jcab41-sys/JC_Desktop_Pad_Releases/Mode_d_emploi_JCharles_Touch.pdf

# JCharles Touch

## Mode d'emploi du pad et du logiciel JCharles desktop

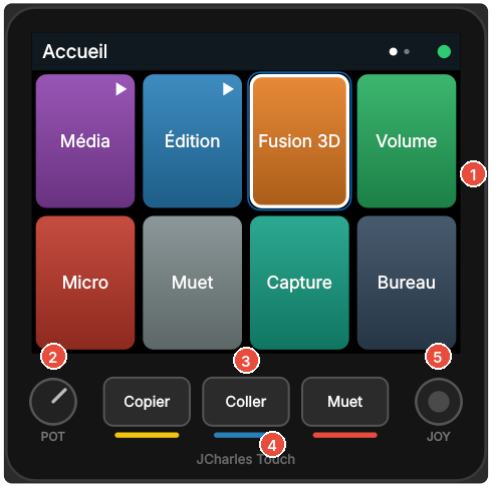
[picture p1: figure]

### 1. Le pad en bref 2. Installer et connecter 3. L'Éditeur : vos boutons 4. Les types d'action 5. Dossiers et glisser-déposer

### 6. Macros 7. Touches physiques et combinaisons 8. Pages Appareil, Matériel, Apparence 9. Les écrans du pad 10. Mises à jour et dépannage

Logiciel 0.31 · pad V2 firmware 2.14. Les captures du logiciel viennent de la version 0.31 ; les écrans du pad sont redessinés d'après le programme du pad.

## 1. Le pad en bref

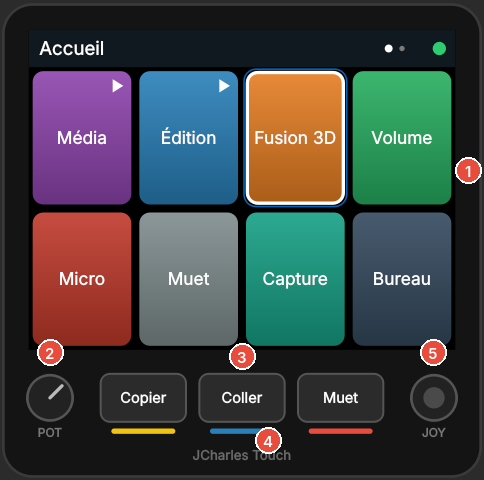
[picture p2: figure]

Le pad se branche au PC par un câble USB. Il peut aussi fonctionner en Bluetooth, sur batterie. La V2 a aussi un petit haut-parleur (jeux, minuteur) et peut recevoir un micro en option.

Le pad se suffit à lui-même pour les raccourcis clavier, le texte et les touches multimédia. Le logiciel JCharles desktop sert à le configurer, et il doit rester ouvert pour les actions « PC » : lancer un programme, ouvrir un site, la météo, la santé du PC, les tuiles à état.

L'écran tactile (4 pouces sur la V2) : vos boutons, appelés « tuiles », rangés en pages et en dossiers.

1

2 Le potentiomètre (bouton rotatif) : par défaut, il règle le volume du PC.
3 Les 3 touches sensitives (TTP223) : il suffit de les effleurer. Par défaut : Copier, Coller, Muet. 4 Les LED des touches : leur couleur et leur comportement se règlent dans le logiciel.
Le joystick : par défaut, il bouge la souris et son clic fait un clic gauche. Il peut aussi tourner une vue 3D (Fusion 360) ou faire défiler.

5

JCharles Touch — mode d'emploi · page 2 / 27

## 2. Installer et connecter

### Installer le logiciel

Téléchargez JCharles_desktop_Setup.exe depuis la page des versions sur GitHub (dépôt JC_Desktop_Pad_Releases).
Lancez-le. Si Windows affiche « Windows a protégé votre ordinateur », cliquez sur Informations complémentaires, puis sur Exécuter quand même.
Le logiciel s'ouvre et cherche le pad tout seul.

### Connecter le pad

Branchez le câble USB. Le logiciel reconnaît le pad à sa réponse, pas au numéro du port COM. En bas à gauche apparaissent un point vert et « Connecté · JCharles Touch V2 ». Sinon, cliquez sur Se connecter ou sur ☰ Chercher.

1.

2.

3.

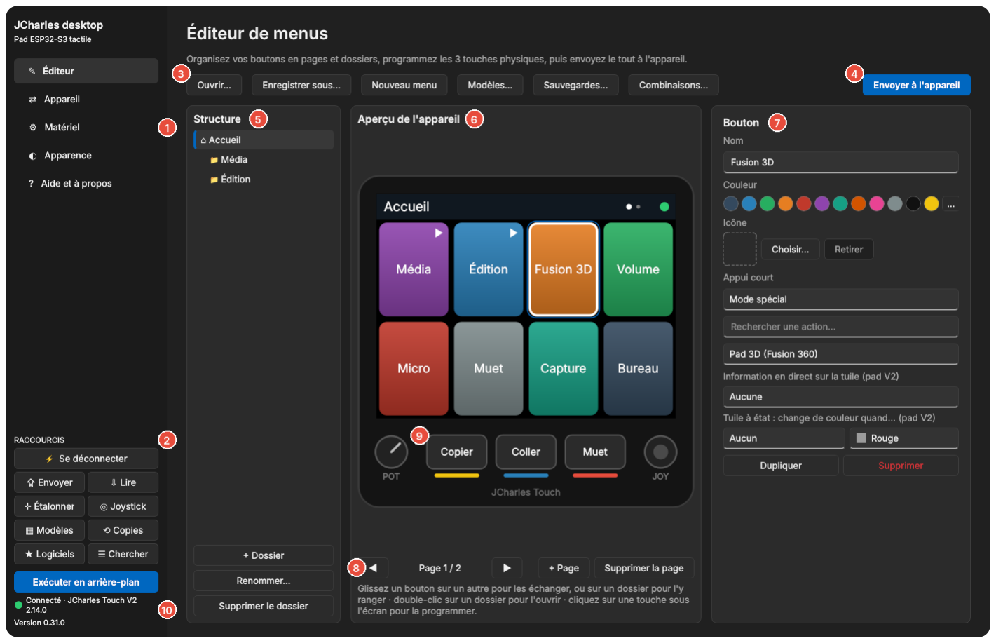
[picture p3: figure]

1 Les pages du logiciel : Éditeur, Appareil, Matériel, Apparence, Aide et à propos. Raccourcis : se connecter, Envoyer (le menu vers le pad), Lire (le menu du pad), Étalonner l'écran, test du Joystick, Modèles, Copies (sauvegardes), Logiciels (un dossier avec vos logiciels les plus utilisés), Chercher le pad.

2

Barre d'outils : ouvrir ou enregistrer un menu sur le PC, repartir d'un nouveau menu, choisir un modèle, retrouver une sauvegarde, régler les combinaisons.

3

Envoyer à l'appareil : copie le menu, les icônes et les réglages dans le pad. Rien ne change sur le pad tant que vous n'avez pas envoyé.

4

5 Structure : l'accueil et ses dossiers, sous forme d'arbre.
6 Aperçu : le pad tel qu'il s'affichera. Cliquez sur une tuile pour la modifier. 7 Panneau de réglage de la tuile ou de la touche sélectionnée.
8 Pages : page précédente / suivante, ajouter une page, supprimer la page.
9 Les touches physiques : cliquez dessus pour les programmer.
État de la connexion et version du logiciel. Exécuter en arrière-plan ferme la fenêtre ; le logiciel continue dans la zone de notification, près de l'horloge.

10

## 3. L'Éditeur : vos boutons

### Créer un bouton

Dans l'aperçu, cliquez sur une case vide marquée +, puis sur Ajouter un bouton. Si la page est pleine, cliquez sur + Page sous l'aperçu.

### Régler un bouton

Cliquez sur la tuile dans l'aperçu : ses réglages s'affichent à droite.

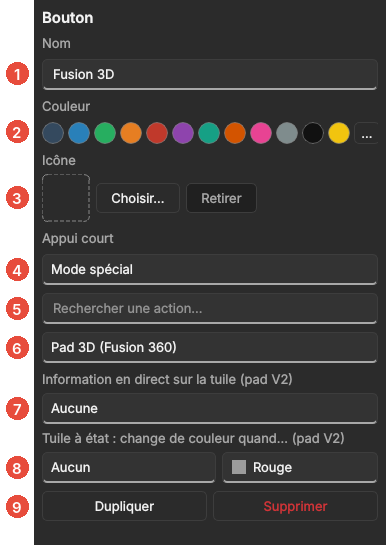
[picture p4: figure]

Pour certains types d'action, une rubrique Appui long (optionnel) apparaît en bas : une seconde action, déclenchée en gardant le doigt 0,6 seconde sur la tuile.

Nom : le texte de la tuile. C'est ici qu'on renomme un bouton.

1

Couleur : une pastille, ou … pour une couleur au choix.

2

Icône : Choisir… une image du PC, ou Retirer. Pour un site ou un logiciel, l'icône est proposée toute seule.

3

Appui court : le type d'action (voir le chapitre 4).

4

Rechercher une action : cliquez dans le champ pour voir toute la liste, ou tapez un mot (« capture », « volume », « dictée »…).

5

Le détail de l'action : il change selon le type choisi.

6

Information en direct (pad V2) : la tuile affiche une valeur à la place de son icône (processeur, mémoire, musique en cours, heure, température).

7

Tuile à état (pad V2) : la tuile change de couleur quand un état est actif (voir plus bas).

8

Dupliquer crée une copie de la tuile ; Supprimer l'efface.

9

### Le menu du clic droit

Clic droit sur une tuile de l'aperçu : Déplacer vers… (un autre dossier ou l'accueil), Déplacer vers la page…, Dupliquer, Supprimer. Sur un dossier, le menu propose aussi Ouvrir le dossier.

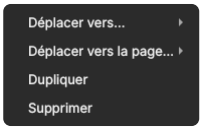
[picture p5: figure]

### Tuiles à état

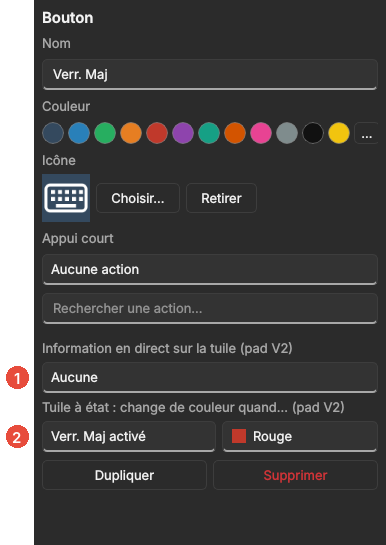
[picture p6: figure]

Exemple : une tuile « Micro » qui coupe le micro et devient rouge quand il est coupé. Les états du PC demandent que le logiciel soit ouvert.

Aucune information en direct ici : la tuile garde son nom et son icône.

1

L'état surveillé et la couleur à prendre. États possibles : micro du PC coupé, son du PC coupé, Verr. Maj activé, Verr. Num activé, micro du pad coupé.

2

## 4. Les types d'action

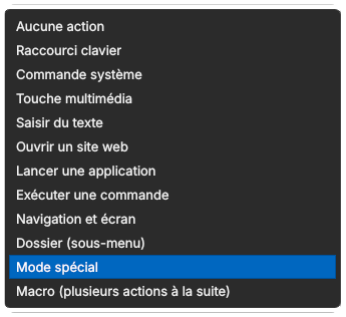
[picture p7: figure]

Choisissez le type dans la liste Appui court. Les champs en dessous s'adaptent.

Le plus rapide : cliquez dans Rechercher une action et choisissez dans la liste. Le type, les touches, le nom et l'icône se remplissent tout seuls.

Type | Ce qu'il fait | Logiciel ouvert ?
Raccourci clavier | Une combinaison de touches. Cochez Ctrl, Maj, Alt ou Win, puis tapez la touche (lettre, chiffre, F1…, enter, esc, tab…). La liste « Choisir un raccourci courant » propose les plus utilisés. | Non
Commande système | Une action Windows toute prête : capture d'écran, dictée vocale, Accès vocal, verrouiller, bureau suivant, presse-papiers, émojis, paramètres… | Selon la commande
Touche multimédia | Lecture / pause, piste suivante ou précédente, volume, muet, luminosité. | Non
Saisir du texte | Tape un texte, accents compris (é, è, à, ç, ù, ê, €…). Réglez le clavier (AZERTY ou QWERTY) dans Matériel. | Non
Ouvrir un site web | Ouvre une adresse dans le navigateur. L'icône du site est récupérée toute seule. | Oui
Lancer une application | Lance un logiciel (bouton Parcourir ou liste des logiciels installés). | Oui
Exécuter une commande | Une ligne de commande Windows. | Oui
Navigation et écran | Page suivante ou précédente, retour à l'accueil, calibrer l'écran tactile, naviguer dans les tuiles avec le joystick. | Non

Dossier (sous-menu) | La tuile ouvre un dossier rempli d'autres tuiles (chapitre 5). | Non
Mode spécial | Ouvre un écran du pad : Pad 3D (Fusion 360), Volume, Météo, Jeux, Pomodoro et minuteurs, Micro, Santé du PC, Présentation (chapitre 9). | Selon l'écran
Macro | Plusieurs actions à la suite, avec des pauses (chapitre 6). | Selon les étapes

Exemple de page avec des modes spéciaux, une macro, une tuile à état et une tuile en direct :

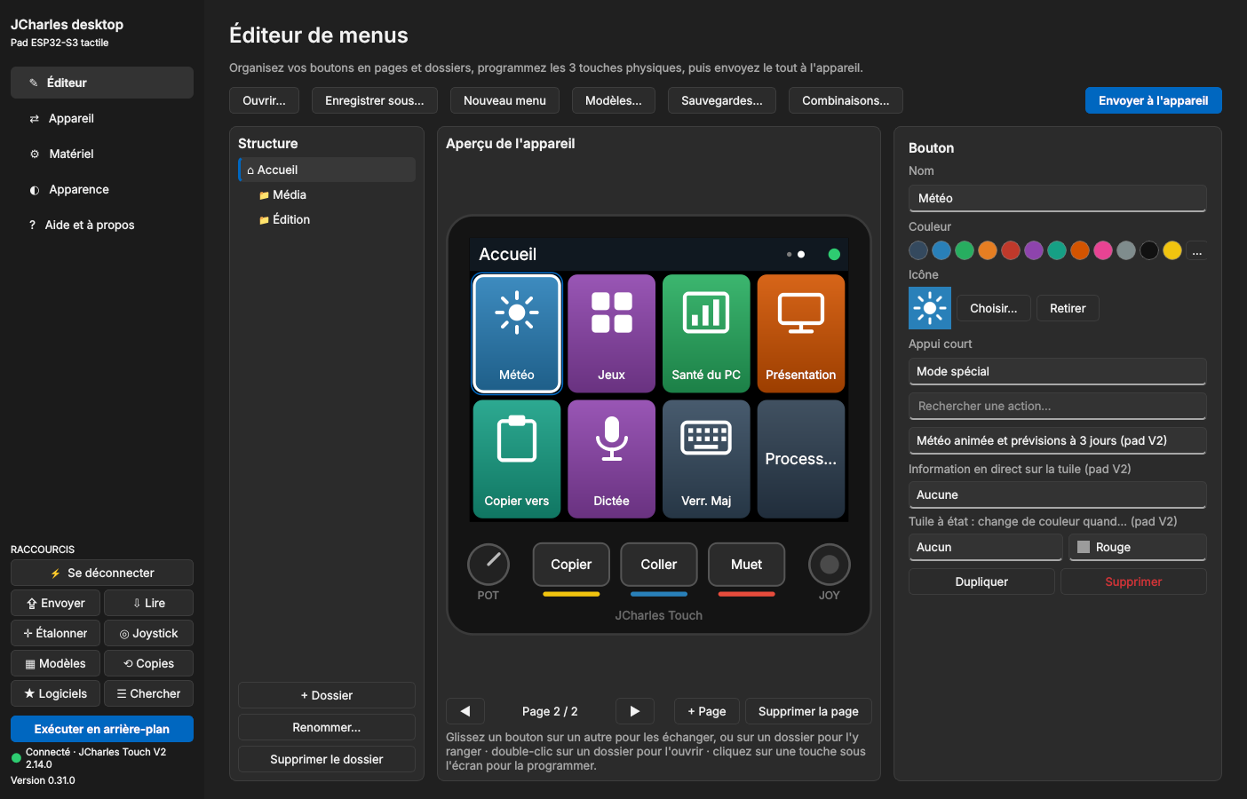
[picture p8: figure]

## 5. Dossiers et glisser-déposer

### Créer un dossier

Cliquez sur + Dossier sous la Structure. Vous pouvez aussi choisir le type Dossier (sous-menu) pour une tuile. Sur le pad, un dossier se reconnaît à son petit triangle blanc en haut à droite.

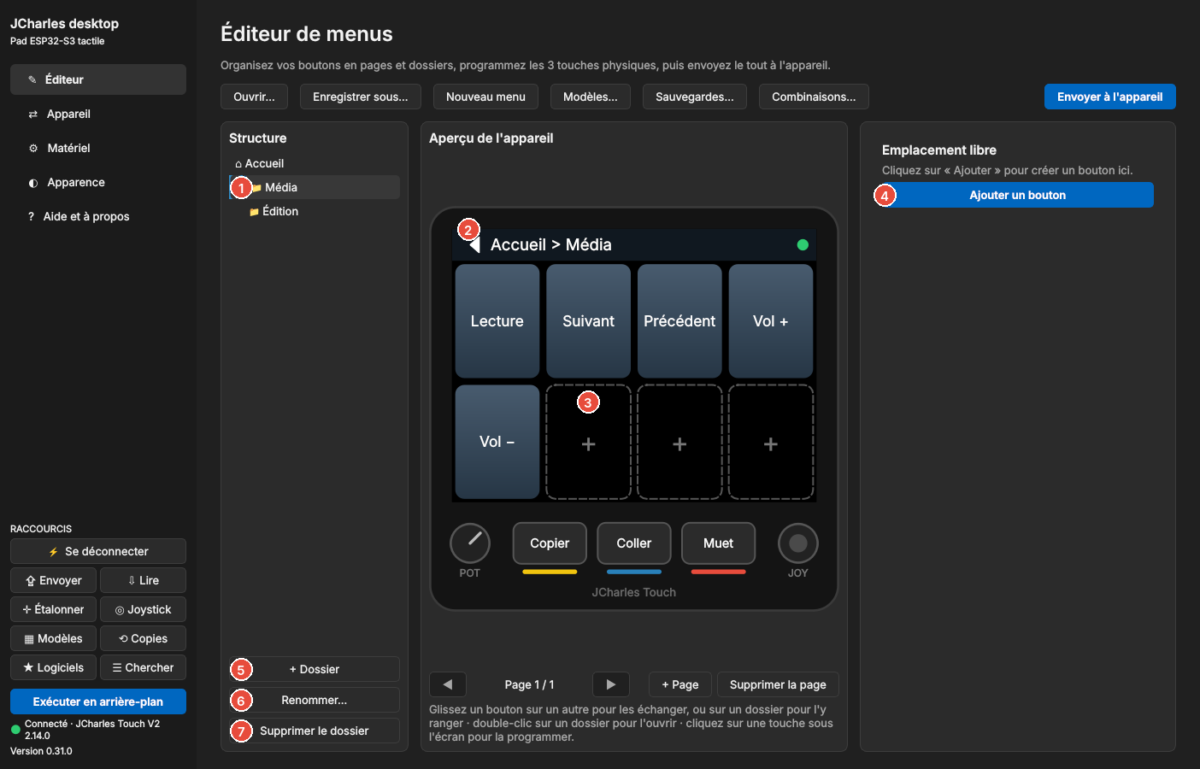
[picture p9: figure]

### Glisser-déposer

Vous faites… | Résultat
Glisser une tuile sur une autre tuile | Les deux tuiles échangent leur place.
Glisser une tuile sur un dossier (dans l'aperçu) | La tuile entre dans le dossier, avec tous ses réglages.

1 Le dossier ouvert dans la Structure : l'aperçu montre son contenu.
2 Le chemin (Accueil > Média) et la flèche de retour, comme sur le pad. 3 Cases libres : cliquez sur un + pour y créer une tuile.
4 Ajouter un bouton dans la case choisie.
5 + Dossier : un nouveau dossier dans le niveau affiché.
6 Renommer… le dossier sélectionné.
7 Supprimer le dossier (avec son contenu).

Glisser une tuile hors de l'aperçu, sur un dossier de la Structure | La tuile est rangée dans ce dossier.
Glisser un dossier dans la Structure | Le dossier change de place : dans un autre dossier, ou de retour à l'accueil.
Glisser une tuile sur la flèche ◀ ou ▶ sous l'aperçu | La tuile passe à la page précédente ou suivante.
Double-clic sur un dossier | Ouvre le dossier.

Pour déplacer une tuile vers une autre page, le plus simple est le clic droit, puis Déplacer vers la page….

## 6. Macros

Une macro enchaîne plusieurs actions avec un seul bouton : par exemple « copier, passer à l'autre fenêtre, coller ».

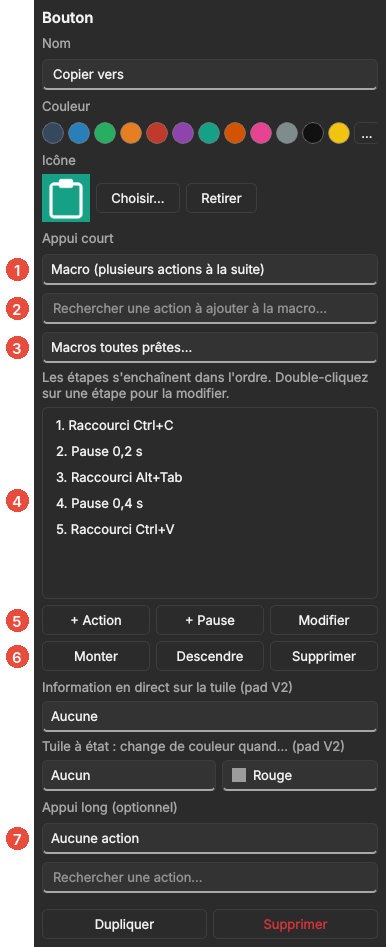
[picture p10: figure]

Si une étape arrive trop tôt (la fenêtre n'est pas encore ouverte), allongez la pause qui la précède.

40 étapes au plus, 10 secondes au plus par pause. Pendant une pause, l'écran du pad ne réagit pas.

1 Type d'action Macro.
Rechercher une action : l'action choisie est ajoutée comme étape.

2

Macros toutes prêtes : copier vers l'autre fenêtre, tout copier, rechercher la sélection, enregistrer et fermer, pause (son coupé et PC verrouillé), bureau propre, Teams (micro et caméra), capture vers Paint, formule de politesse.

3

Les étapes, dans l'ordre. Double-cliquez sur une étape pour la modifier.

4

+ Action ajoute une étape (raccourci, texte, multimédia, site, logiciel,
commande) ; + Pause ajoute une attente ; Modifier l'étape sélectionnée.

5

Monter / Descendre changent l'ordre ; Supprimer enlève l'étape.

6

7 Une macro peut aussi avoir un appui long.

## 7. Touches physiques et combinaisons

Cliquez sur une touche sous l'aperçu (Copier, Coller, Muet…) pour la programmer.

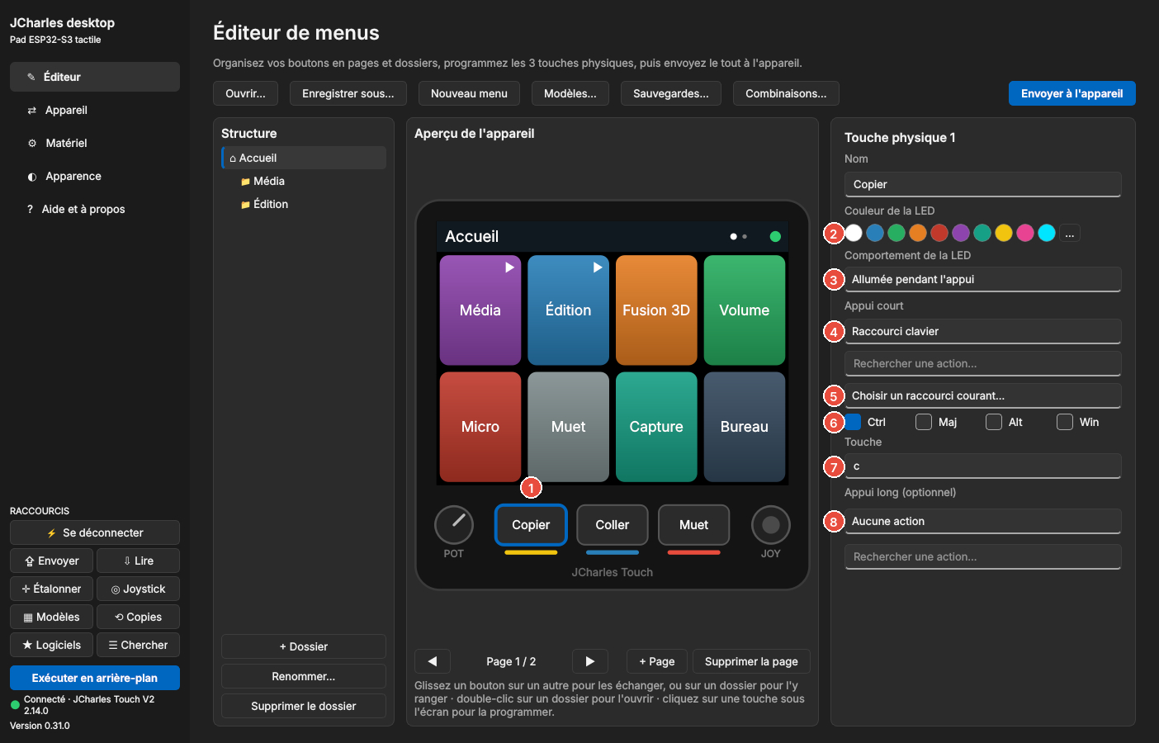
[picture p11: figure]

1 La touche sélectionnée.
2 Couleur de la LED de la touche.
Comportement de la LED : éteinte, allumée pendant l'appui, bascule à chaque appui, ou veilleuse avec pleine lumière à l'appui.

3

Appui court : les mêmes types d'action que les tuiles (sauf dossier et mode spécial), macros comprises.

4

5 « Choisir un raccourci courant » : la liste des raccourcis les plus utilisés.
6 Les touches de modification : Ctrl, Maj, Alt, Win.
7 La touche du raccourci.
8 Appui long : une seconde action en gardant le doigt sur la touche.

### Combinaisons

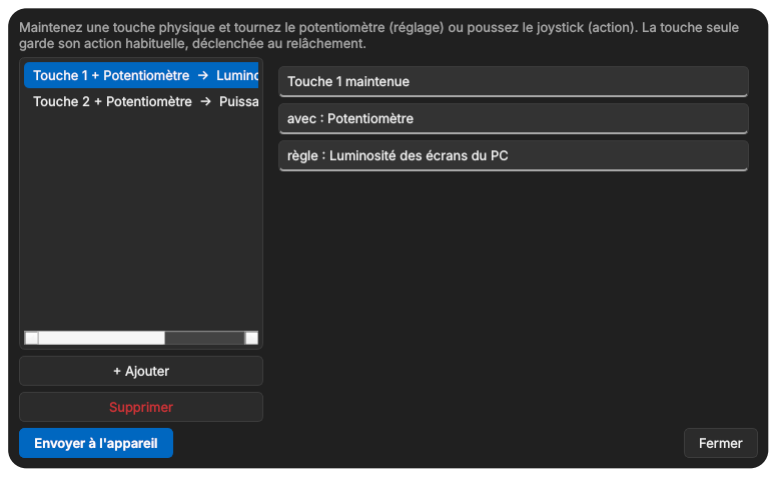
[picture p12: figure]

Bouton Combinaisons… de la barre d'outils. Maintenez une touche physique et :

- tournez le potentiomètre pour régler autre chose : luminosité des écrans du PC, puissance du micro du PC, luminosité de l'écran du pad ou des LED, volume ;
- poussez le joystick pour déclencher une action.

La touche seule garde son action habituelle, déclenchée au relâchement.

### Modèles et sauvegardes

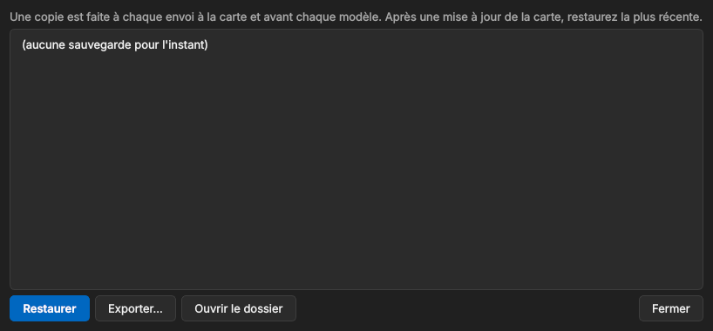
[picture p13: figure]
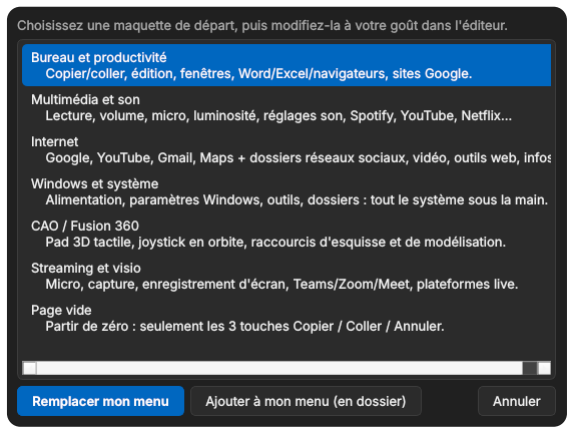
[picture p14: figure]

Modèles… : un menu tout prêt pour démarrer (bureau et productivité, multimédia et son, Internet, Windows et système, CAO / Fusion 360, streaming et visio, page vide), à modifier ensuite. Sauvegardes… : une copie du menu est faite à chaque envoi au pad et avant chaque modèle. En cas d'erreur, restaurez la plus récente.

## 8. Pages Appareil, Matériel, Apparence

### Appareil

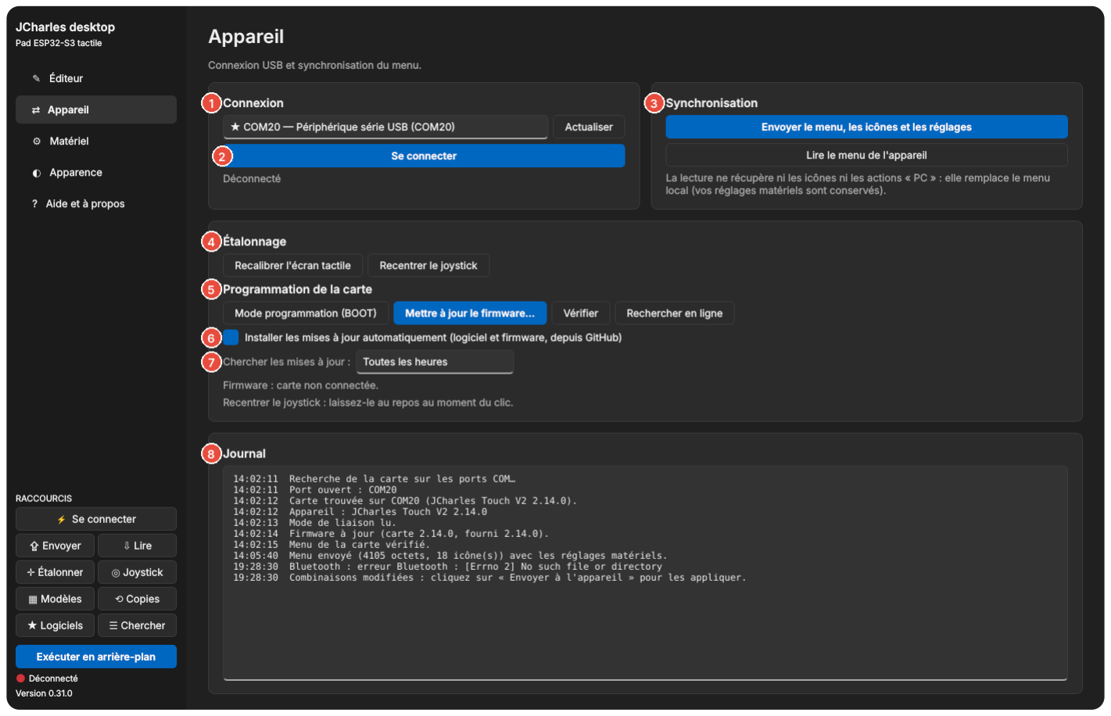
[picture p15: figure]

### Matériel

Tous les réglages du pad. Ils partent au pad avec Envoyer à l'appareil, sauf mention contraire.

1 Connexion : le port COM du pad, et Actualiser.
2 Se connecter / Se déconnecter.
Synchronisation : envoyer le menu, les icônes et les réglages ; ou lire le menu du pad (sans les icônes ni les actions PC).

3

Étalonnage : recalibrer l'écran tactile, recentrer le joystick (laissez-le au repos au moment du clic).

4

Programmation de la carte : mode programmation, Mettre à jour le firmware…, Vérifier, Rechercher en ligne.

5

6 Mises à jour automatiques du logiciel et du firmware, depuis GitHub.
7 Rythme de recherche des mises à jour.
8 Journal : ce que fait le logiciel. À copier pour signaler un problème.

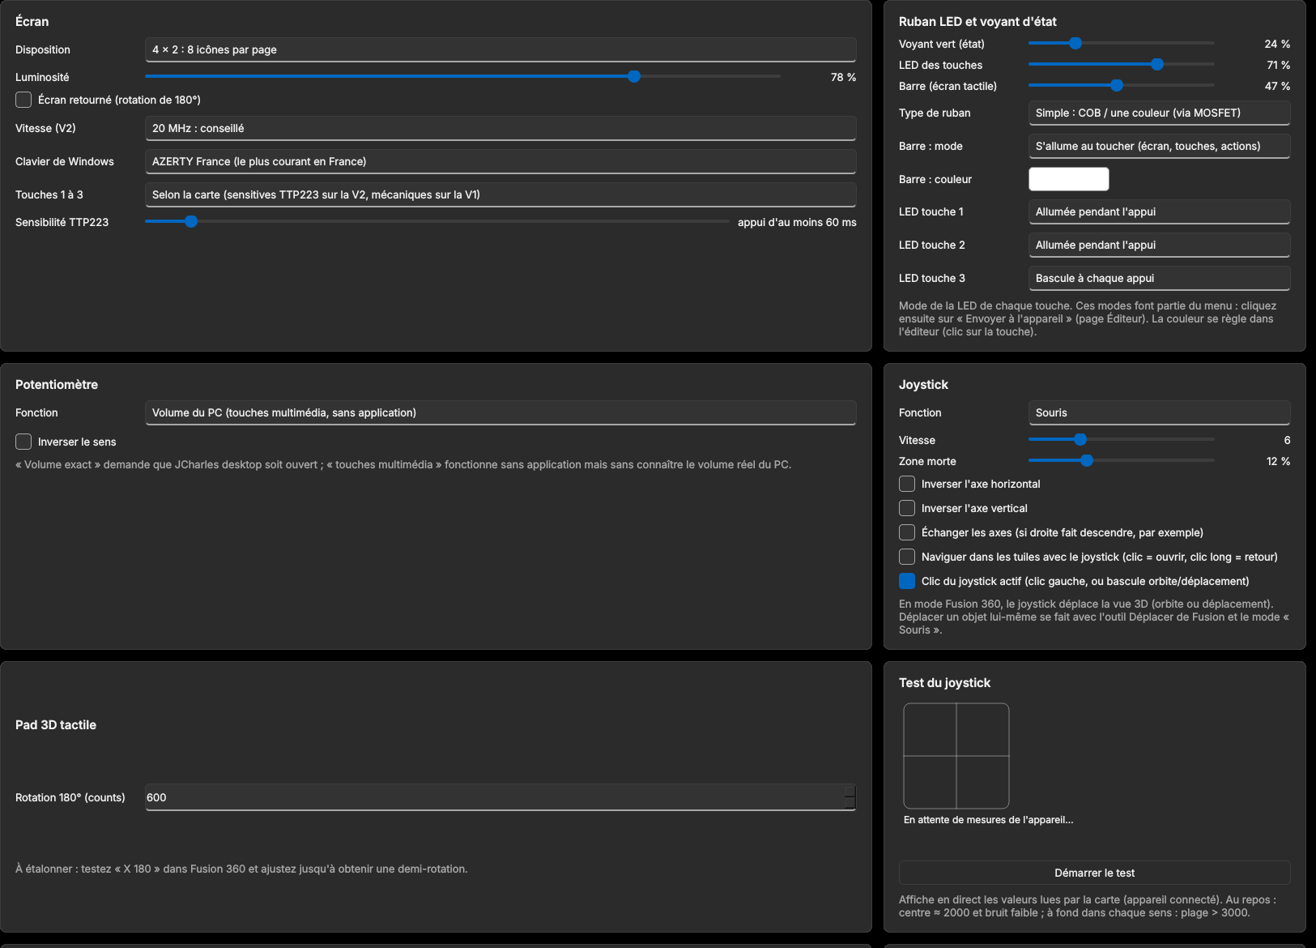
[picture p16: figure]

Rubrique | Ce qu'on y règle
Écran | Disposition (4 × 2 ou 3 × 2 tuiles), luminosité, écran retourné, Clavier de Windows (AZERTY France ou QWERTY US), type et sensibilité des touches.
Ruban LED et voyant | Luminosité du voyant, des LED des touches et du ruban ; type de ruban ; mode et couleur de la barre ; comportement de chaque LED.
Potentiomètre | Sa fonction (volume du PC, volume exact, luminosité de l'écran du pad, intensité des LED, désactivé), sens inversé.
Joystick | Fonction (souris, orbite 3D, déplacement 3D, défilement), vitesse, zone morte, axes, navigation dans les tuiles, clic.
Test du joystick / Pad 3D | Valeurs lues en direct ; réglage de la rotation de 180° pour Fusion 360.
Liaison avec le PC | USB, Bluetooth ou automatique ; oublier les appairages Bluetooth ; tester le Bluetooth.
Écran tactile | Sensibilité et calibration.

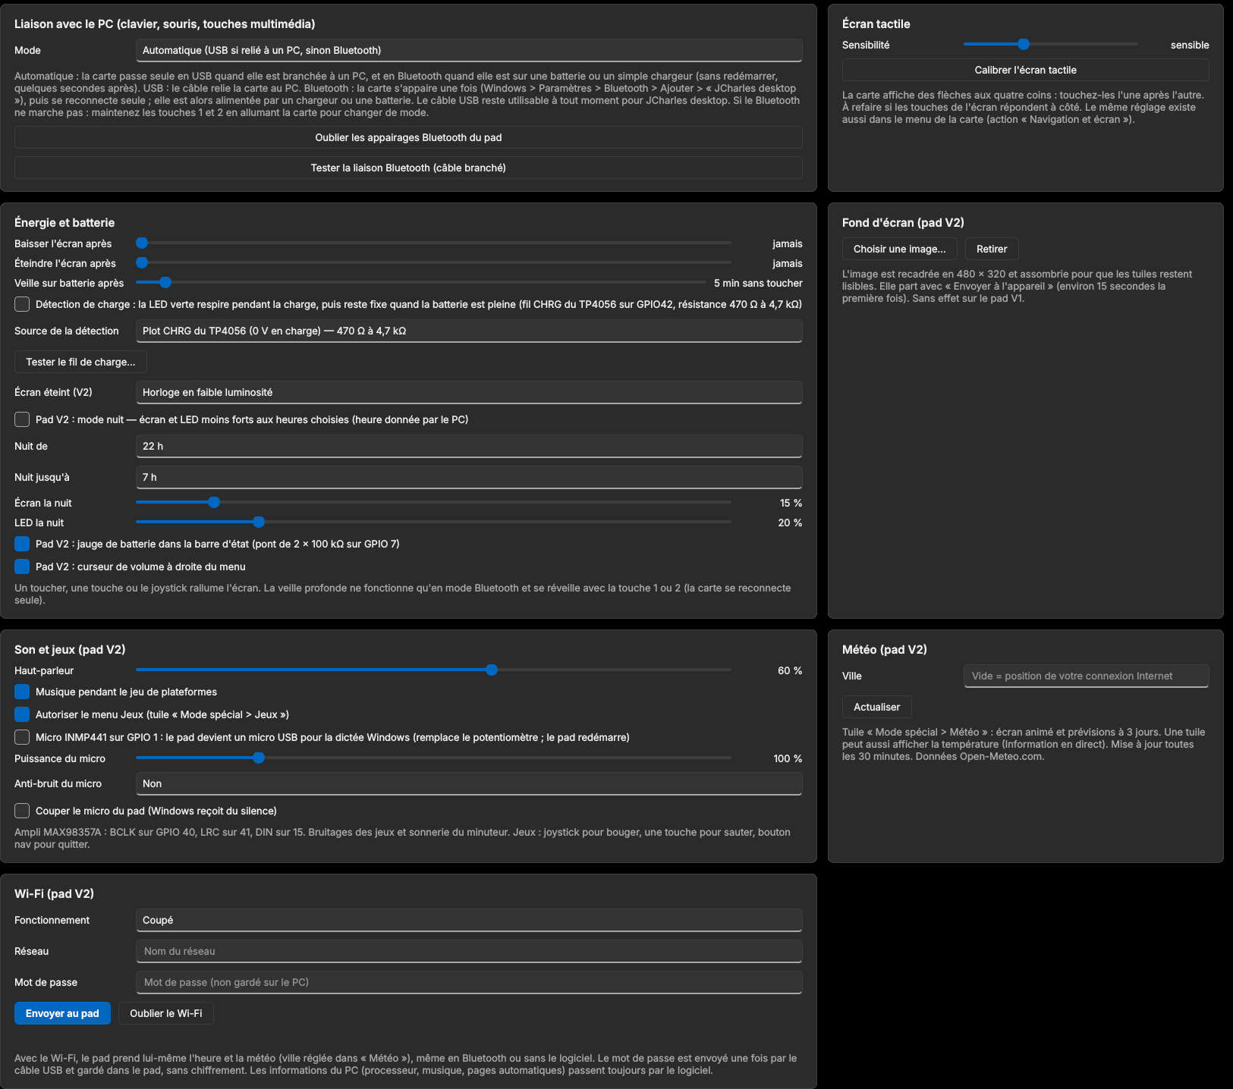
[picture p17: figure]

Rubrique | Ce qu'on y règle
Énergie et batterie | Baisser puis éteindre l'écran, veille sur batterie, détection de charge, horloge de veille, mode nuit (heures, luminosité de l'écran et des LED la nuit), jauge de batterie, curseur de volume à droite du menu.
Fond d'écran (V2) | Une image derrière les tuiles.
Son et jeux (V2) | Volume du haut-parleur, musique, menu Jeux, micro du pad (activation, puissance, anti-bruit, couper).
Météo (V2) | La ville (vide = position de la connexion Internet).
Wi-Fi (V2) | Pour que le pad prenne lui-même l'heure et la météo.

### Apparence

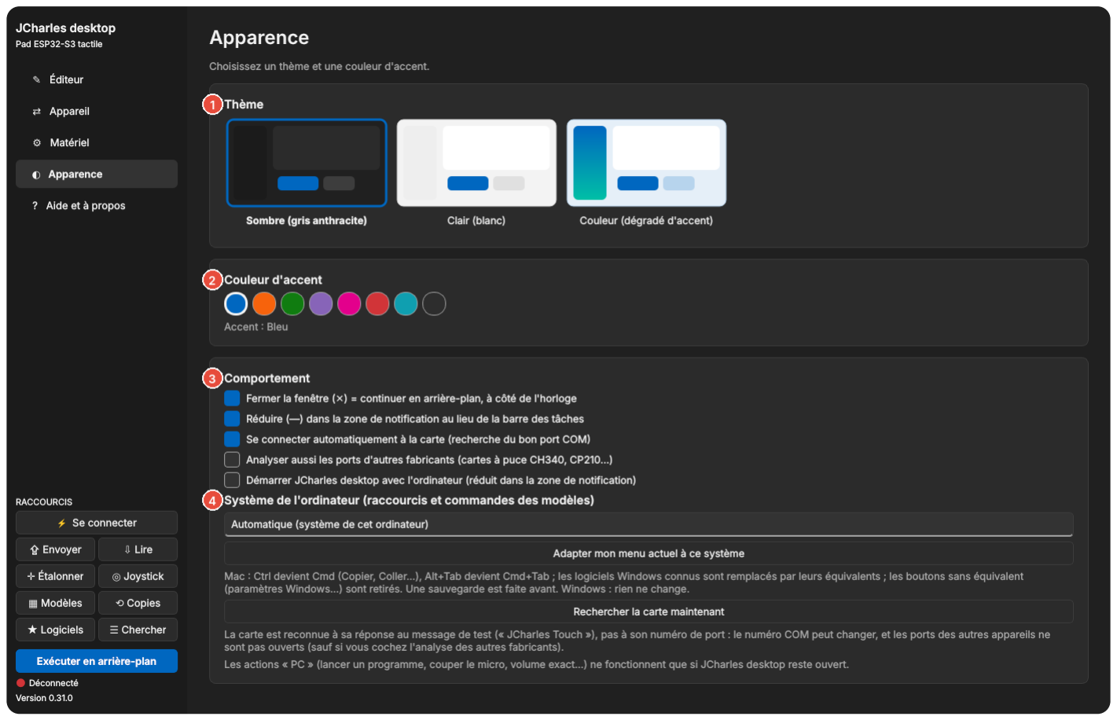
[picture p18: figure]

1 Thème du logiciel : sombre, clair ou couleur.
2 Couleur d'accent.
Comportement : fermer ou réduire dans la zone de notification, connexion automatique, démarrage avec Windows.

3

4 Système de l'ordinateur : adapte les raccourcis pour un Mac si besoin.

## 9. Les écrans du pad

### Le menu

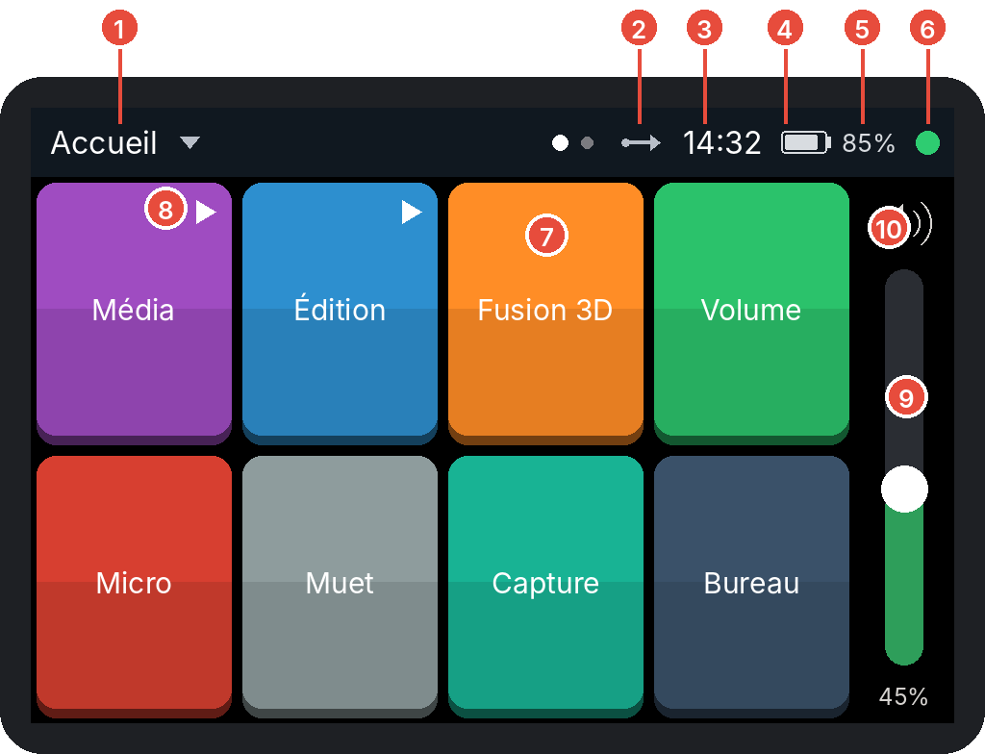
[picture p19: figure]

Glissez le doigt vers la gauche ou la droite pour changer de page. Dans un dossier, la flèche ◀ en haut à gauche ramène au niveau précédent.

1 Le titre (nom de la page ou du dossier). Touchez l'en-tête pour ouvrir l'écran Raccourcis. 2 Les points de page : le point blanc est la page affichée.
3 La liaison : symbole USB ou Bluetooth.
4 L'heure, donnée par le PC (ou le Wi-Fi).
5 La batterie.
6 Le voyant PC : vert = logiciel JCharles desktop connecté.
7 Une tuile : touchez-la pour lancer son action ; gardez le doigt 0,6 s pour l'appui long. 8 Un dossier : petit triangle blanc.
9 Le curseur de volume : glissez de haut en bas.
10 Le haut-parleur : touchez-le pour couper ou rétablir le son du PC.

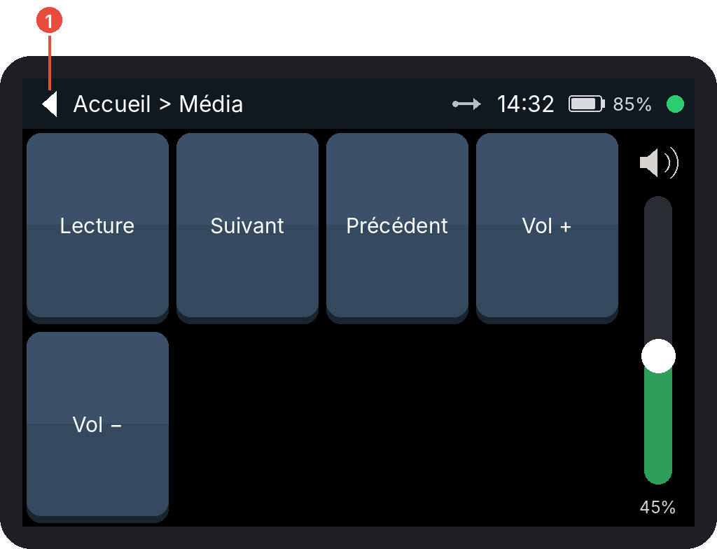
[picture p20: figure]

Un dossier ouvert : (1) retour.

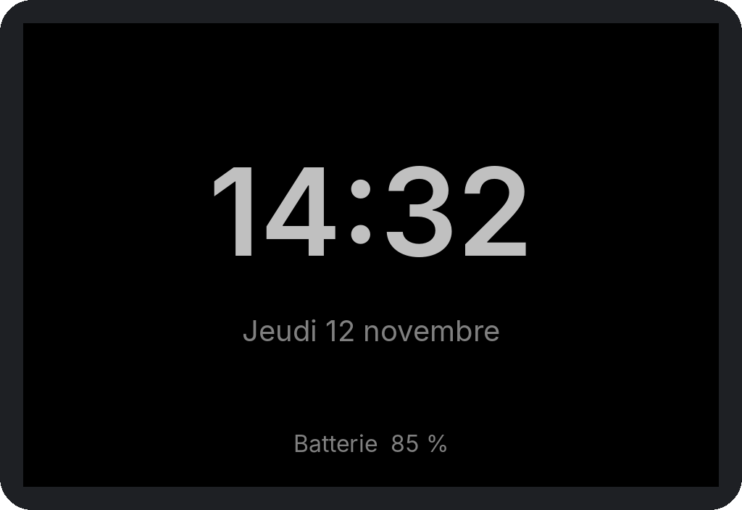
[picture p21: figure]

Écran de veille : l'horloge en faible lumière. Touchez pour rallumer.

### Raccourcis (toucher l'en-tête)

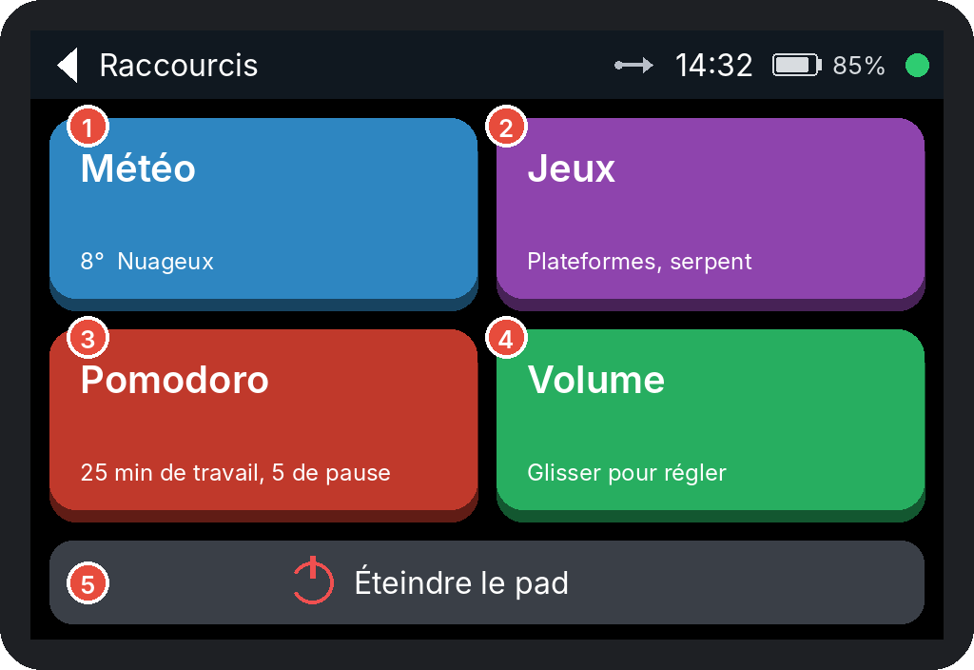
[picture p22: figure]

1 Météo.
2 Jeux.
Pomodoro : 25 min de travail, 5 min de pause ; touchez de nouveau pour l'arrêter.

3

4 Volume.
5 Éteindre le pad.

### Volume et Pad 3D

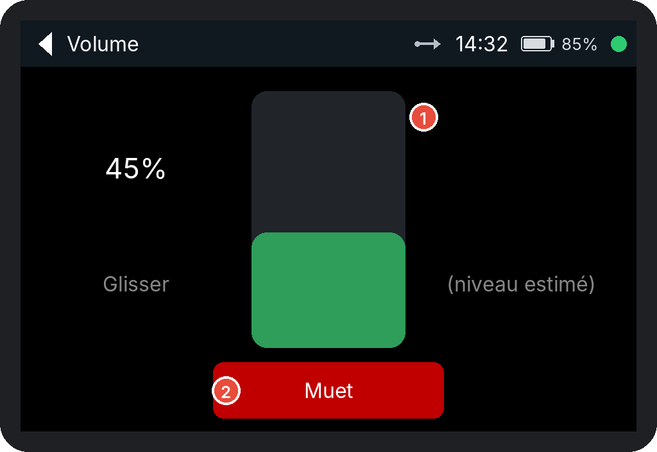
[picture p23: figure]

1 Glissez pour régler le volume. 2 Muet.

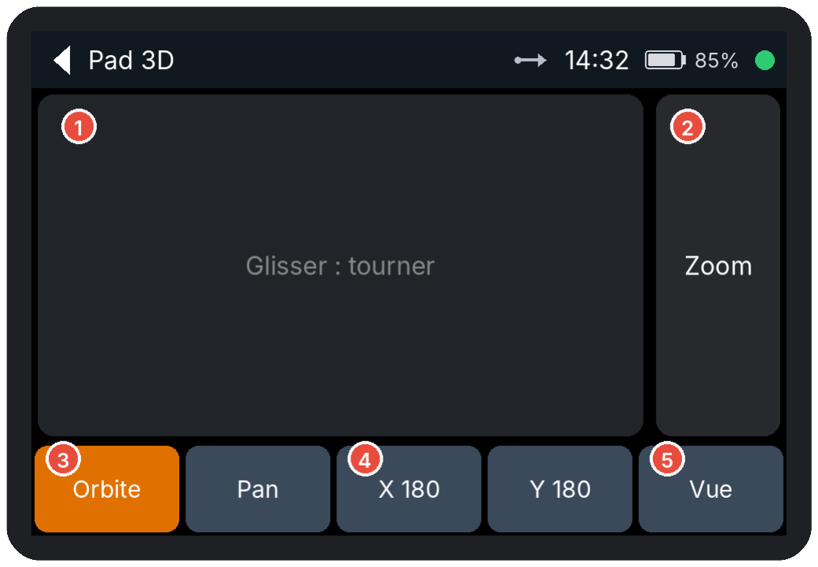
[picture p24: figure]

Glissez pour tourner la vue (ou la déplacer en mode Pan).

1

2 Glissez pour zoomer.
3 Orbite / Pan : tourner ou déplacer. 4 X 180 / Y 180 : demi-tour.
5 Vue : vue d'origine.

### Jeux

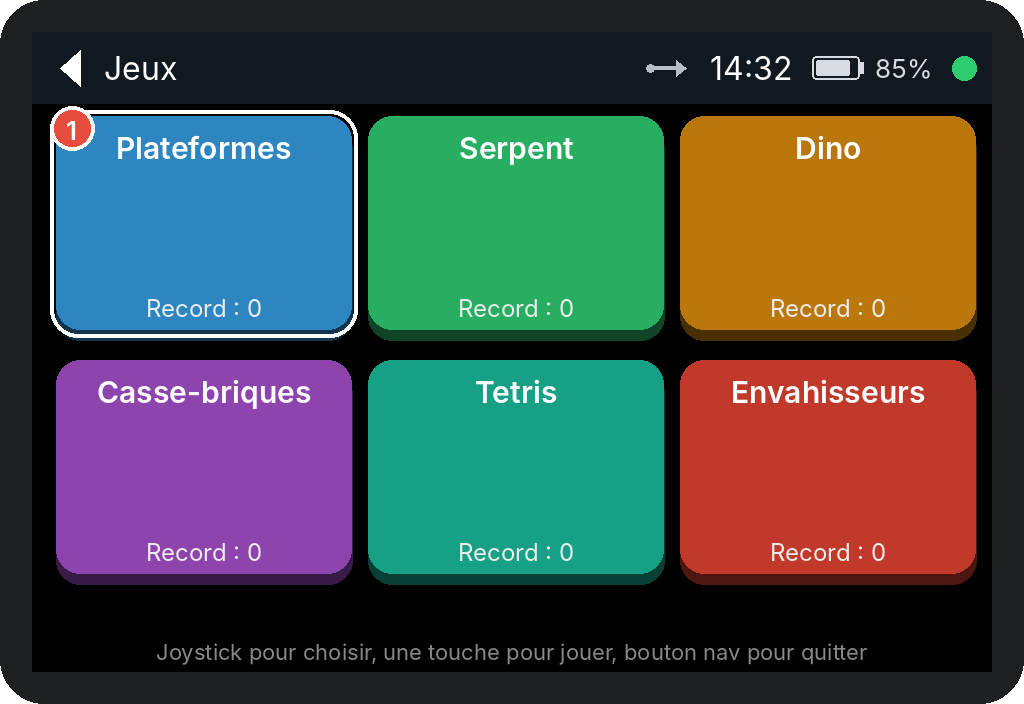
[picture p25: figure]

Le jeu choisi (cadre blanc). Joystick pour choisir, une touche pour jouer. Chaque jeu garde son record.

1

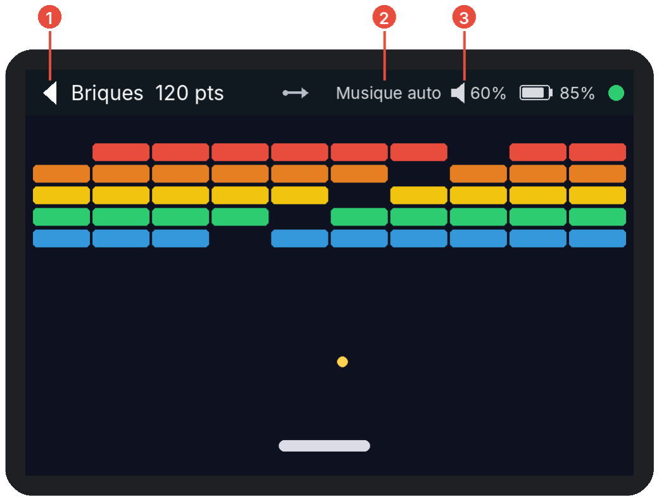
[picture p26: figure]

1 Retour à la liste des jeux.
Musique : touchez pour passer de « Musique auto » à Musique 1, 2, 3, puis Muet.

2

Volume du haut-parleur : touchez pour le changer.

3

Jeu | Commandes
Plateformes (Bip) | Joystick pour avancer, une touche pour sauter. 8 tableaux jusqu'au drapeau.
Serpent | Joystick pour tourner.
Dino | Une touche (ou toucher l'écran) pour sauter par-dessus les cactus.
Casse-briques | Joystick ou doigt pour la raquette ; une touche lance la balle.
Tetris | Joystick gauche / droite pour déplacer, haut pour tourner, bas pour accélérer ; une touche pour la chute rapide.
Envahisseurs | Joystick ou doigt pour le vaisseau ; une touche (ou le doigt) pour tirer.

### Micro (pad avec micro INMP441)

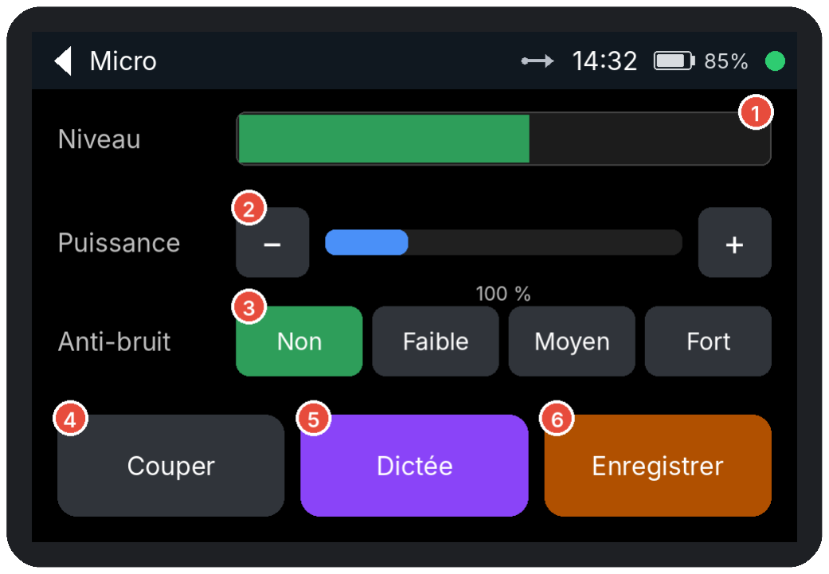
[picture p27: figure]

S'ouvre tout seul avec la dictée vocale (Win+H) ou l'Accès vocal, par une tuile ou une touche.

### Santé du PC

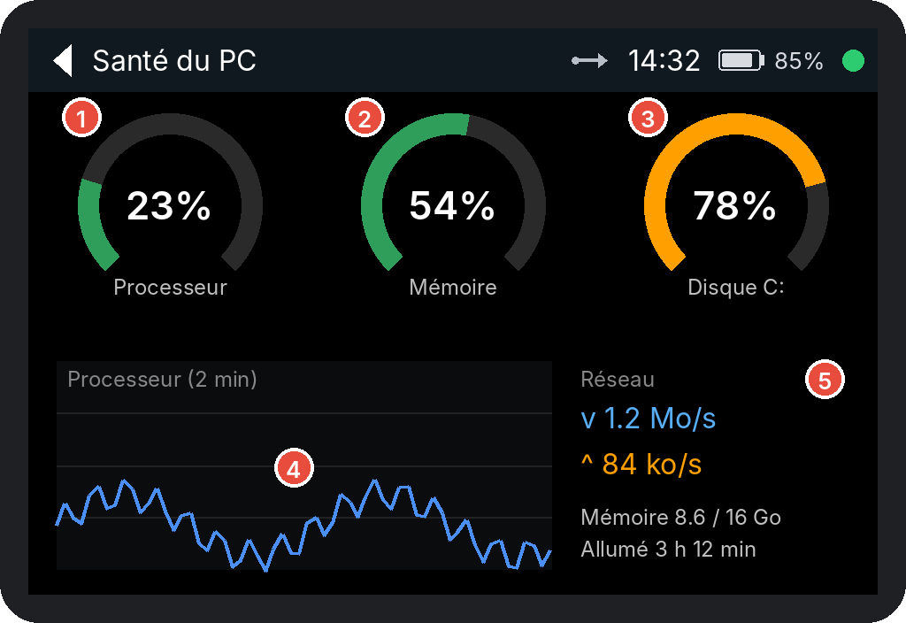
[picture p28: figure]

Le logiciel doit être ouvert.

Niveau en direct (orange puis rouge si trop fort).

1

Puissance : − / + ou toucher la barre (25 à 400 %).

2

Anti-bruit : coupe le son tant que vous ne parlez pas.

3

4 Couper / Réactiver.
5 Dictée : relance Win+H.
Enregistrer : ouvre l'Enregistreur vocal de Windows (logiciel ouvert).

6

1 Processeur.
2 Mémoire.
Disque C: (vert, orange au-delà de 70 %, rouge au-delà de 90 %).

3

4 La courbe du processeur sur 2 minutes. Le réseau (réception ▼, envoi ▲), la mémoire utilisée et la durée depuis l'allumage du PC.

5

### Présentation

Marche avec PowerPoint, Google Slides et la plupart des lecteurs PDF. L'écran reste allumé tant que le chronomètre tourne.

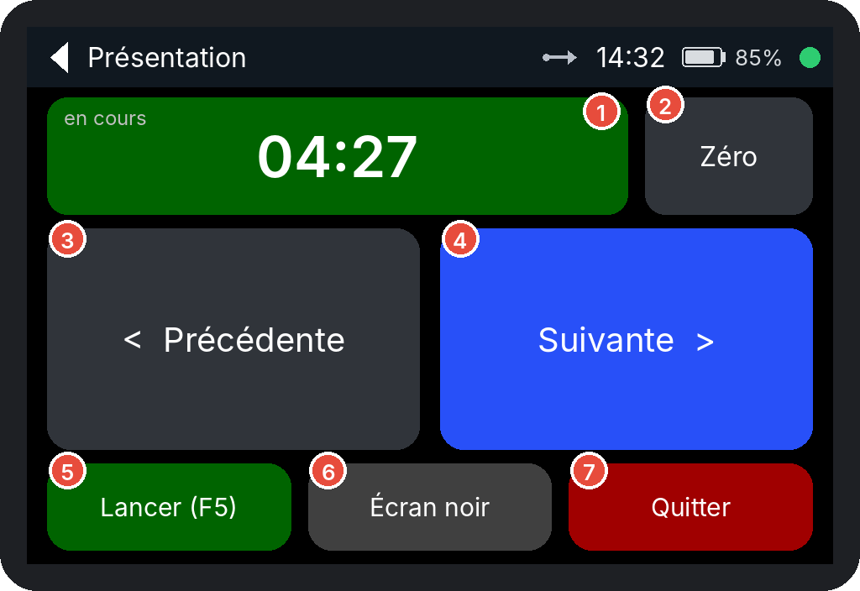
[picture p29: figure]

Chronomètre : démarre à la première slide ; touchez-le pour la pause.

1

2 Zéro : remise à zéro.
3 Précédente.
Suivante (le joystick à gauche / à droite marche aussi).

4

5 Lancer le diaporama (F5).
6 Écran noir (touche B).
7 Quitter le diaporama (Échap).

### Météo

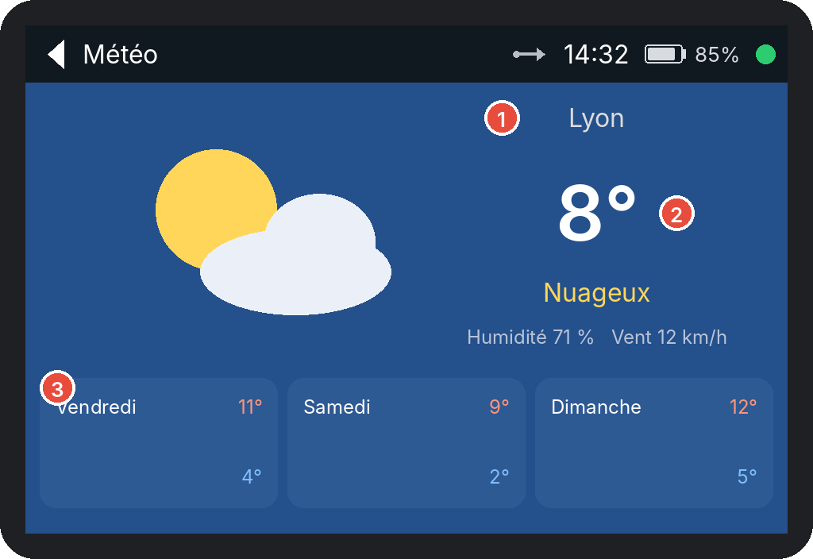
[picture p30: figure]

La météo vient du logiciel (ou du Wi-Fi du pad). Données Open-Meteo.

1 La ville.
La température, le temps, l'humidité et le vent.

2

Les 3 jours suivants (maximum et minimum).

3

## 10. Mises à jour et dépannage

### Mettre à jour

Avec « Installer les mises à jour automatiquement » coché (page Appareil), le logiciel installe lui-même les nouvelles versions du logiciel et du firmware. Sinon : Rechercher en ligne, puis Mettre à jour le firmware…, le pad branché en USB.

Pendant la mise à jour du firmware, ne débranchez pas le câble et fermez le Moniteur série
de l'Arduino IDE s'il est ouvert. Vos tuiles, la calibration et l'appairage Bluetooth sont conservés.

### Problèmes courants

Problème | Solution
Le pad n'est pas trouvé | Vérifiez le câble (certains câbles ne font que charger). Cliquez sur ☰ Chercher. Fermez l'Arduino IDE ou tout autre logiciel qui utilise le port COM.
Une modification ne se voit pas sur le pad | Cliquez sur Envoyer à l'appareil.
Le texte tapé est faux (« q » au lieu de « a ») | Matériel > Écran > Clavier de Windows : choisissez AZERTY France, puis envoyez.
L'écran répond à côté du doigt | Étalonner (raccourcis) ou Matériel > Écran tactile > Calibrer.
Le joystick bouge tout seul | Page Appareil > Recentrer le joystick, ou augmentez la zone morte dans Matériel.
Le Bluetooth se connecte et se déconnecte sans arrêt | Dans Windows (Paramètres > Bluetooth et appareils), supprimez « JCharles desktop », puis ajoutez-le de nouveau.
Les actions PC, la météo ou la santé du PC ne marchent pas | Le logiciel doit être ouvert : vérifiez son icône près de l'horloge.
« Rechercher en ligne » ne répond pas | Fermez complètement le logiciel (icône près de l'horloge > Quitter) et relancez-le.

Ce mode d'emploi est disponible dans le logiciel (Aide et à propos > Mode d'emploi) et sur la page GitHub des versions.
