jcab41-sys/JC_Desktop_Pad_Releases/stl/V2_couvercle_micro_rond.stl

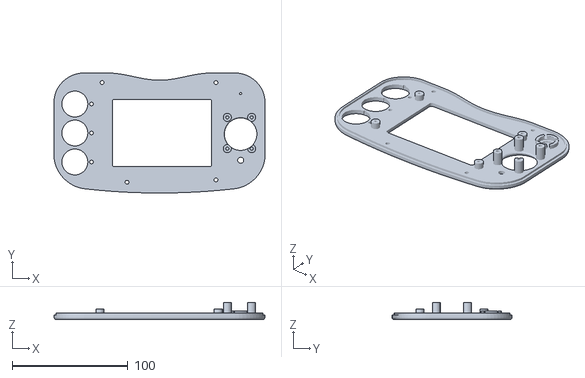
[picture p31: CAD file, 2026-11-11]
stl/V2_couvercle_micro_rond.stl
182.0 x 103.5 x 14.8
