jcab41-sys/JC_Desktop_Pad_Releases/(list of files, cad)

Other CAD files:
stl/V2_couvercle_micro_rect.stl
stl/V2_couvercle.stl
