jcab41-sys/JC_Desktop_Pad_Releases/(commit log)

2026-11-11 Couvercle V2 : trou du micro reculé (35 mm devant le joystick) et berceau à clips
    Claude-Session: https://claude.ai/code/session_01JSB37DaaTbB1Egbv4kpYvg
    [V2_couvercle.stl, V2_couvercle_micro_rect.stl, V2_couvercle_micro_rond.stl, boitier_v2.scad]
2026-11-11 Firmware 2.5.1 / 0.9.3 et couvercle micro : dégagement devant la carte, 4 clips
    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
    [V2_couvercle_micro_rect.stl, V2_couvercle_micro_rond.stl, boitier_v2.scad]
2026-11-11 Firmware source : cablage de l'ampli mis a jour (10 kOhm DIN-GND)
    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
